JohnZonneveld/topcase_E470_leds/(commit log)

2025-11-02 Adjust pulse timing and interval values
    Finished wiring up the bike and adjusted the turnsignals. With the set times the sequential turnsignal is finished before the lights turn off. So the topcase lights are in sync with the bike's turnsignals.
    Had some flicker when braking and turn signals but that also has been solved.
    Only thing that still has to be adjusted is the brake signal flash. On my bike there is already a brake modulator installed for the brake light.
    [topcase_millis_2.ino]
2025-11-08 added 2nd brake flash to comply with flash pattern of my brakelight strobe
2025-11-09 Increase brake flash counter limits and adjust timing
2025-11-23 Refactor brake and hazard functions for efficiency
    Removed unnecessary Serial.print statements and adjusted the blink timing logic for better performance for the hazards.
2025-11-27 Revise README for topcase E470 LED updates
    Updated README to reflect new features and adjustments for the top case LED system, including installation details and timing adjustments for turn signals.
